gemarcano/cartreader/hardware/main_pcb_hw5/main_pcb_hw5.kicad_pcb

## KiCad design hardware/main_pcb_hw5/main_pcb_hw5.kicad_pcb (2024-12-26)

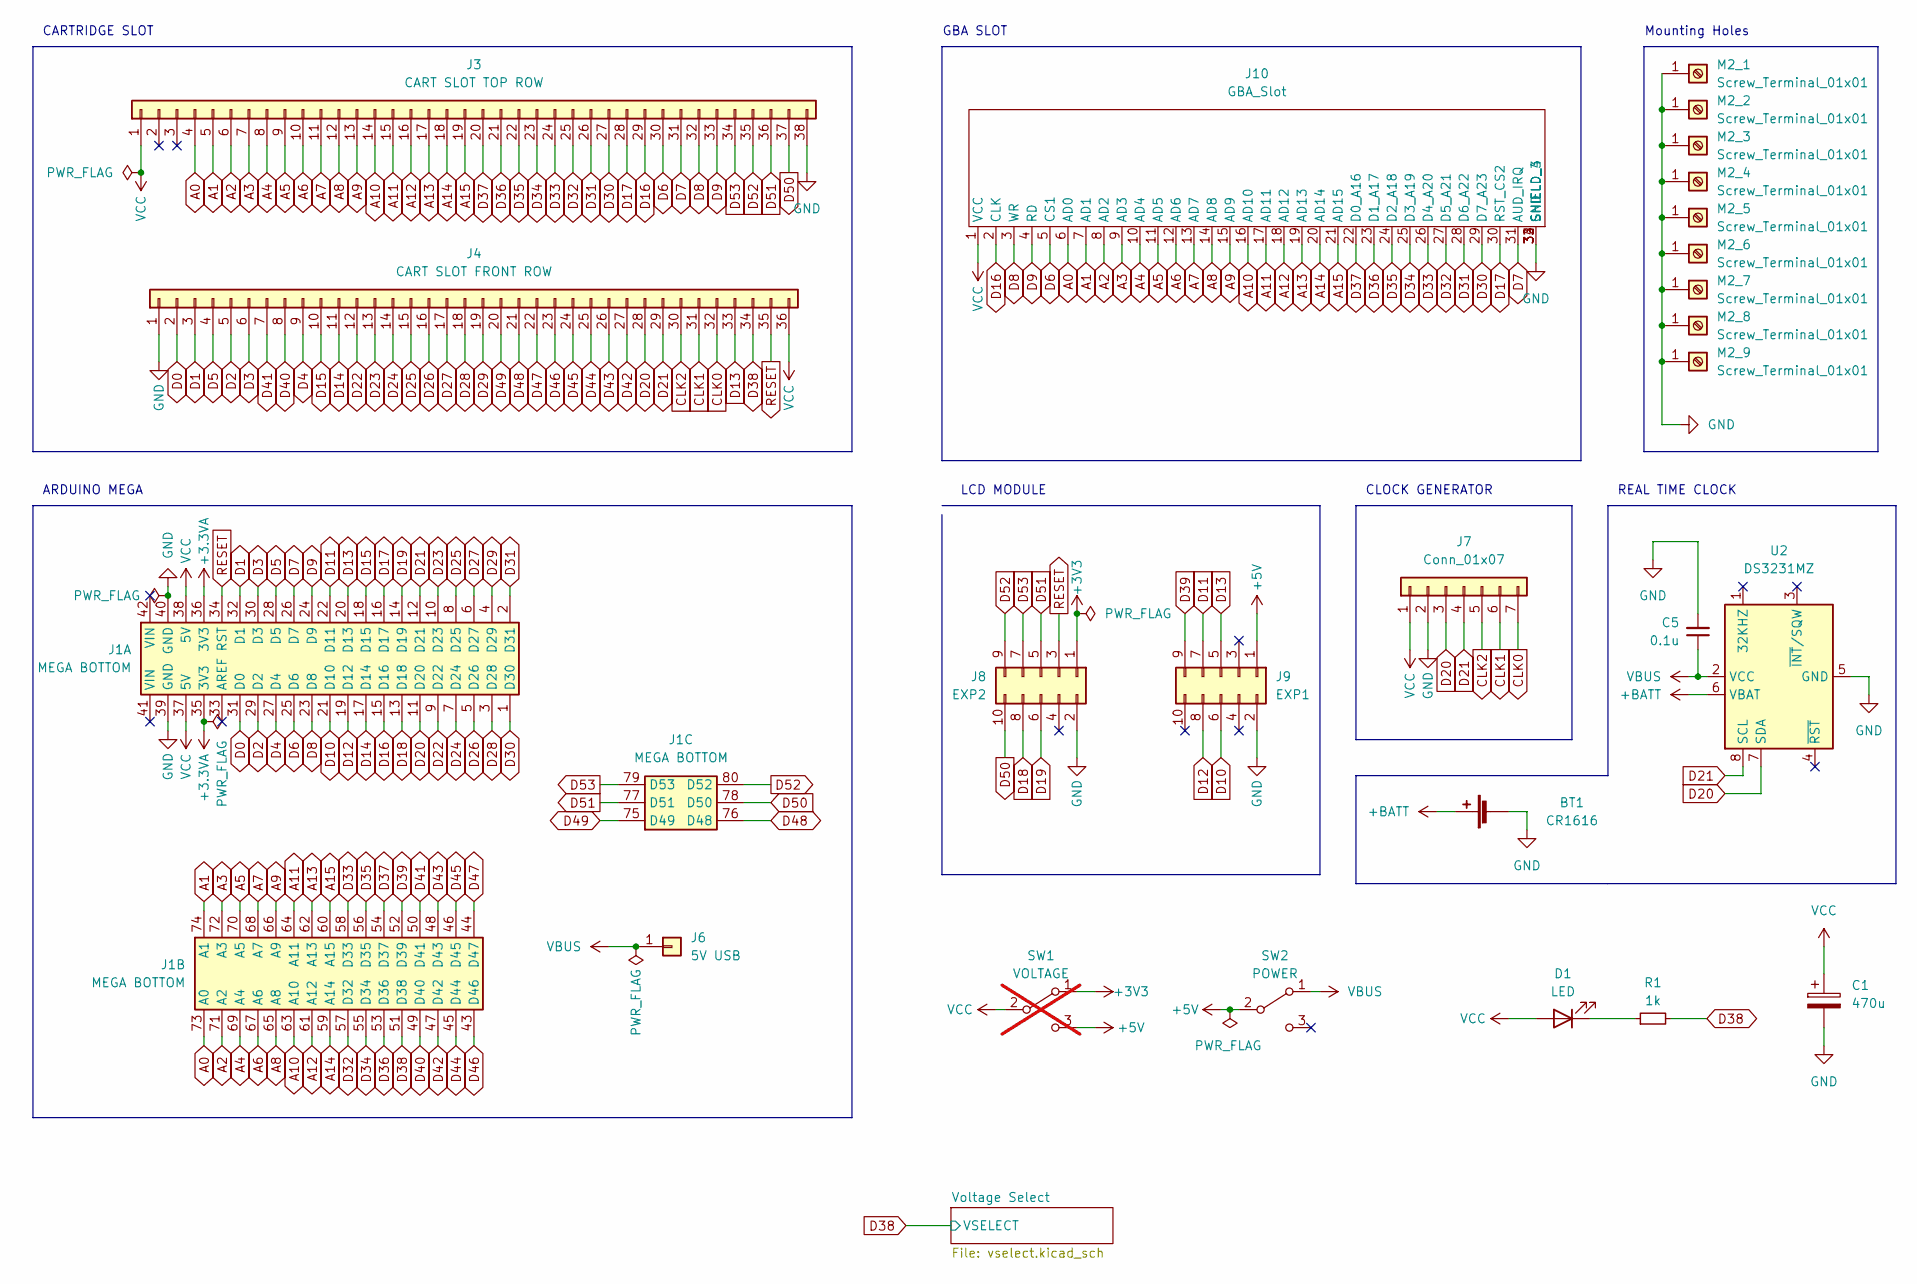
[picture p1: schematic main_pcb_hw5.kicad_sch, OSCR HW5]

Parts:
BT1: CR1616
C1: 470u; CP_Radial_D8.0mm_P3.50mm
C5: 0.1u; C_0603_1608Metric_Pad1.08x0.95mm_HandSolder; JLCPCB C307331
D1: LED; LED_0603_1608Metric_Pad1.05x0.95mm_HandSolder
J1: MEGA BOTTOM; MEGA2560_PRO_MINI
J3: CART SLOT TOP ROW; Cartridge_Port_Adapter-Back
J4: CART SLOT FRONT ROW; Cartridge_Port_Adapter-Front
J6: 5V USB; PinHeader_1x01_P2.54mm_Vertical
J7: Conn_01x07; Clock_Generator_Header
J8: EXP2; LCD_Header
J9: EXP1; LCD_Header
J10: GBA_Slot
M2_1, M2_2, M2_3, M2_4, M2_5, M2_6, M2_7, M2_8, M2_9: Screw_Terminal_01x01; MountingHole_2.2mm_M2_ISO7380_Pad
R1: 1k; R_0603_1608Metric_Pad0.98x0.95mm_HandSolder
SW1: VOLTAGE; Power_Switch; not fitted
SW2: POWER; Power_Switch
U2: DS3231MZ; SOIC-8_3.9x4.9mm_P1.27mm

Connections:
+3.3VA: J1.35 (3V3), J1.36 (3V3)
+3V3: J8.1, SW1.1 (A); also elsewhere on the board
+5V: J9.1, SW1.3 (C), SW2.2 (B); also elsewhere on the board
+BATT: BT1.1 (+), U2.6 (VBAT)
A0: J1.73 (A0), J3.4, J10.6 (AD0)
A1: J1.74 (A1), J3.5, J10.7 (AD1)
A2: J1.71 (A2), J3.6, J10.8 (AD2)
A3: J1.72 (A3), J3.7, J10.9 (AD3)
A4: J1.69 (A4), J3.8, J10.10 (AD4)
A5: J1.70 (A5), J3.9, J10.11 (AD5)
A6: J1.67 (A6), J3.10, J10.12 (AD6)
A7: J1.68 (A7), J3.11, J10.13 (AD7)
A8: J1.65 (A8), J3.12, J10.14 (AD8)
A9: J1.66 (A9), J3.13, J10.15 (AD9)
A10: J1.63 (A10), J3.14, J10.16 (AD10)
A11: J1.64 (A11), J3.15, J10.17 (AD11)
A12: J1.61 (A12), J3.16, J10.18 (AD12)
A13: J1.62 (A13), J3.17, J10.19 (AD13)
A14: J1.59 (A14), J3.18, J10.20 (AD14)
A15: J1.60 (A15), J3.19, J10.21 (AD15)
CLK0: J4.32, J7.7
CLK1: J4.31, J7.6
CLK2: J4.30, J7.5
D0: J1.31 (D0), J4.2
D1: J1.32 (D1), J4.3
D2: J1.29 (D2), J4.5
D3: J1.30 (D3), J4.6
D4: J1.27 (D4), J4.9
D5: J1.28 (D5), J4.4
D6: J1.25 (D6), J3.30, J10.5 (CS1)
D7: J1.26 (D7), J3.31, J10.31 (AUD_IRQ)
D8: J1.23 (D8), J3.32, J10.3 (WR)
D9: J1.24 (D9), J3.33, J10.4 (RD)
D10: J1.21 (D10), J9.6
D11: J1.22 (D11), J9.7
D12: J1.19 (D12), J9.8
D13: J1.20 (D13), J4.33, J9.5
D14: J1.17 (D14), J4.11
D15: J1.18 (D15), J4.10
D16: J1.15 (D16), J3.29, J10.2 (CLK)
D17: J1.16 (D17), J3.28, J10.30 (RST_CS2)
D18: J1.13 (D18), J8.8
D19: J1.14 (D19), J8.6
D20: J1.11 (D20), J4.28, J7.3, U2.7 (SDA)
D21: J1.12 (D21), J4.29, J7.4, U2.8 (SCL)
D22: J1.9 (D22), J4.12
D23: J1.10 (D23), J4.13
D24: J1.7 (D24), J4.14
D25: J1.8 (D25), J4.15
D26: J1.5 (D26), J4.16
D27: J1.6 (D27), J4.17
D28: J1.3 (D28), J4.18
D29: J1.4 (D29), J4.19
D30: J1.1 (D30), J3.27, J10.29 (D7_A23)
D31: J1.2 (D31), J3.26, J10.28 (D6_A22)
D32: J1.57 (D32), J3.25, J10.27 (D5_A21)
D33: J1.58 (D33), J3.24, J10.26 (D4_A20)
D34: J1.55 (D34), J3.23, J10.25 (D3_A19)
D35: J1.56 (D35), J3.22, J10.24 (D2_A18)
D36: J1.53 (D36), J3.21, J10.23 (D1_A17)
D37: J1.54 (D37), J3.20, J10.22 (D0_A16)
D38: J1.51 (D38), J4.34, R1.2; also elsewhere on the board
D39: J1.52 (D39), J9.9
D40: J1.49 (D40), J4.8
D41: J1.50 (D41), J4.7
D42: J1.47 (D42), J4.27
D43: J1.48 (D43), J4.26
D44: J1.45 (D44), J4.25
D45: J1.46 (D45), J4.24
D46: J1.43 (D46), J4.23
D47: J1.44 (D47), J4.22
D48: J1.76 (D48), J4.21
D49: J1.75 (D49), J4.20
D50: J1.78 (D50), J3.37, J8.10
D51: J1.77 (D51), J3.36, J8.5
D52: J1.80 (D52), J3.35, J8.9
D53: J1.79 (D53), J3.34, J8.7
GND: BT1.2 (-), C1.2, C5.2, J1.39 (GND), J1.40 (GND), J3.38, J4.1, J7.2, J8.2, J9.2, J10.32 (GND), J10.33 (SHIELD_3), J10.34 (SHIELD_4), M2_1.1, M2_2.1, M2_3.1, M2_4.1, M2_5.1, M2_6.1, M2_7.1, M2_8.1, M2_9.1, U2.5 (GND); also elsewhere on the board
unnamed: D1.1 (K), R1.1
RESET: J1.34 (RST), J4.35, J8.3
VBUS: C5.1, J6.1, SW2.1 (A), U2.2 (VCC)
VCC: C1.1, D1.2 (A), J1.37 (5V), J1.38 (5V), J3.1, J4.36, J7.1, J10.1 (VCC), SW1.2 (B); also elsewhere on the board

Notes on the sheet:
LCD MODULE
REAL TIME CLOCK
CLOCK GENERATOR
CARTRIDGE SLOT
GBA SLOT
ARDUINO MEGA
Mounting Holes

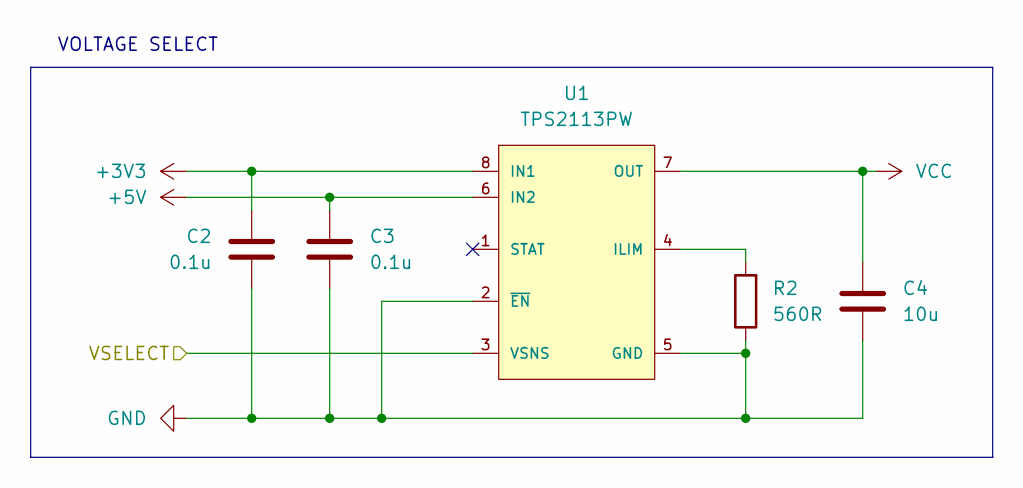
[picture p2: schematic vselect.kicad_sch]

Parts:
C2, C3: 0.1u; C_0603_1608Metric_Pad1.08x0.95mm_HandSolder; JLCPCB C307331
C4: 10u; C_0603_1608Metric_Pad1.08x0.95mm_HandSolder; JLCPCB C15525
R2: 560R; R_0603_1608Metric_Pad0.98x0.95mm_HandSolder; JLCPCB C137858
U1: TPS2113PW; Texas_Instruments-TPS2113PW-Level_A

Connections:
+3V3: C2.2, U1.8 (IN1); also elsewhere on the board
+5V: C3.1, U1.6 (IN2); also elsewhere on the board
D38: U1.3 (VSNS); also elsewhere on the board
GND: C2.1, C3.2, C4.2, R2.1, U1.2 (~EN), U1.5 (GND); also elsewhere on the board
unnamed: R2.2, U1.4 (ILIM)
VCC: C4.1, U1.7 (OUT); also elsewhere on the board

Notes on the sheet:
VOLTAGE SELECT

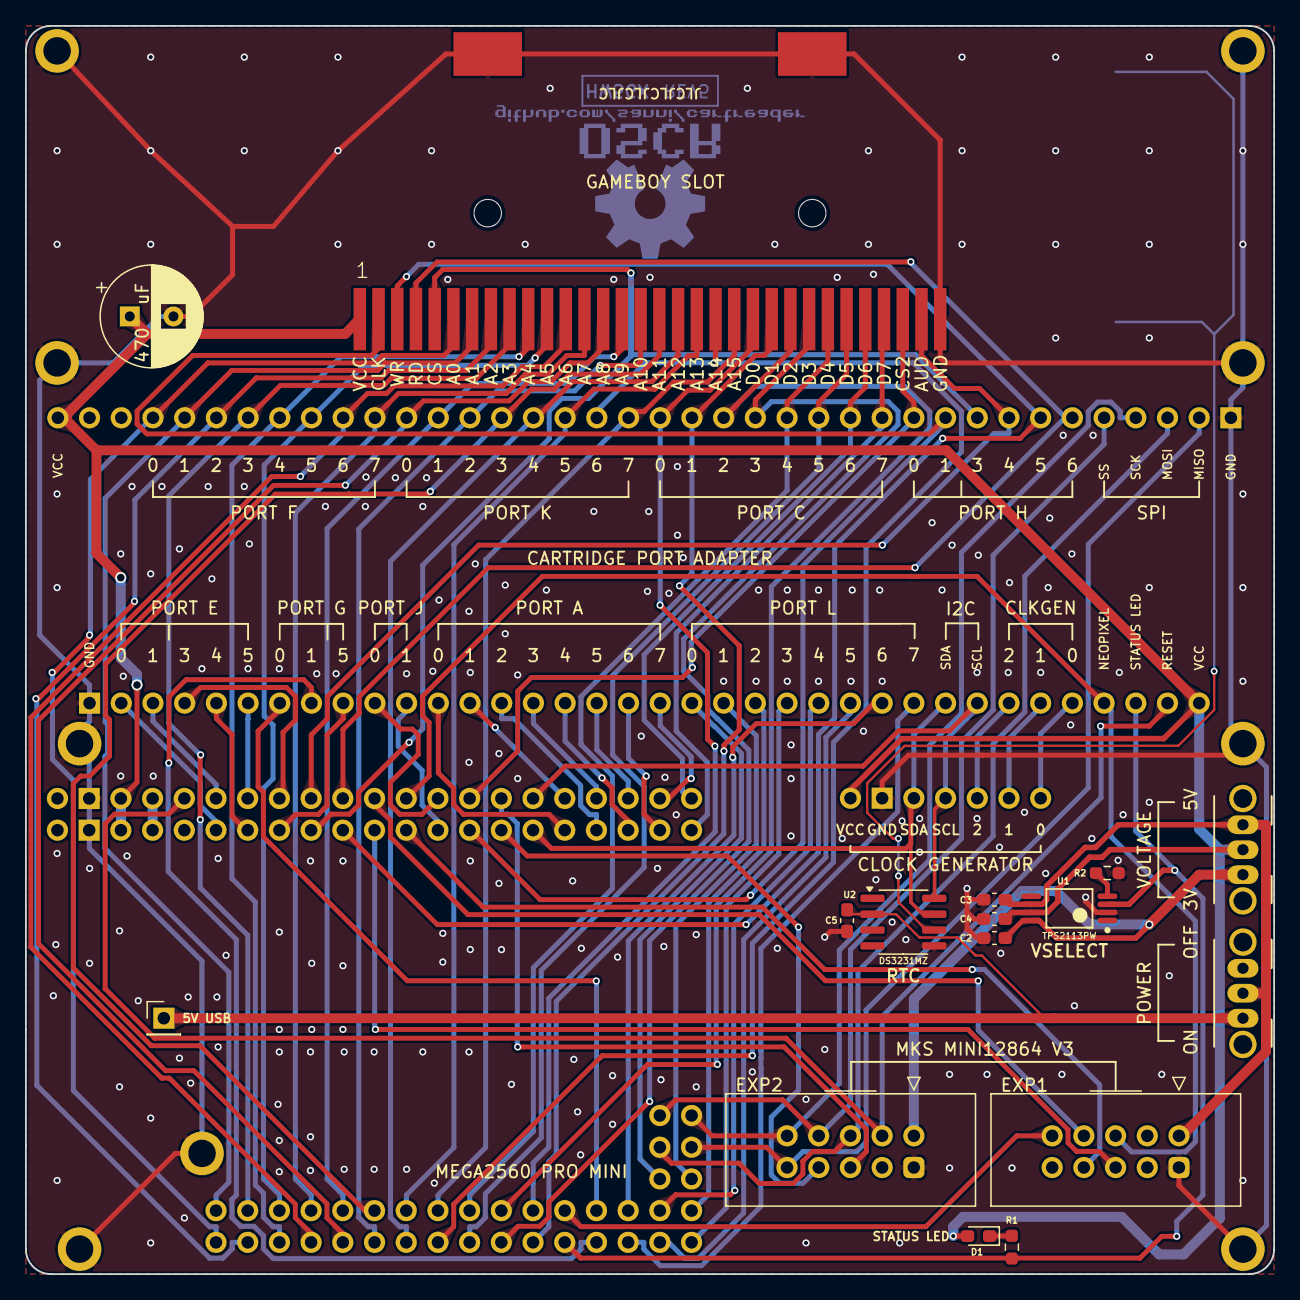
[picture p3: board main_pcb_hw5.kicad_pcb from above]

Board: 2 copper layers, 100.0 x 100.0 mm, 30 parts (1 on the bottom side), 83 nets.
