gemarcano/cartreader/(commit log)

2024-12-05 Changed 0402 components to 0603
    - Also tweaked name in board graphics to make it clear this isn't a
    vanilla board.
    [main_pcb_hw5.kicad_pcb, main_pcb_hw5.kicad_sch, vselect.kicad_sch]
2024-12-05 Made LED and its resistor SMD, added teardrops
    [main_pcb_hw5.kicad_pcb, main_pcb_hw5.kicad_sch]
2024-12-13 Sent out PCB for manufacturing
    [main_pcb_hw5.kicad_pcb]
